sparkfunX/Qwiic_Spectral_Sensor-AS726x/Hardware/AS726xBasicShroud.stl

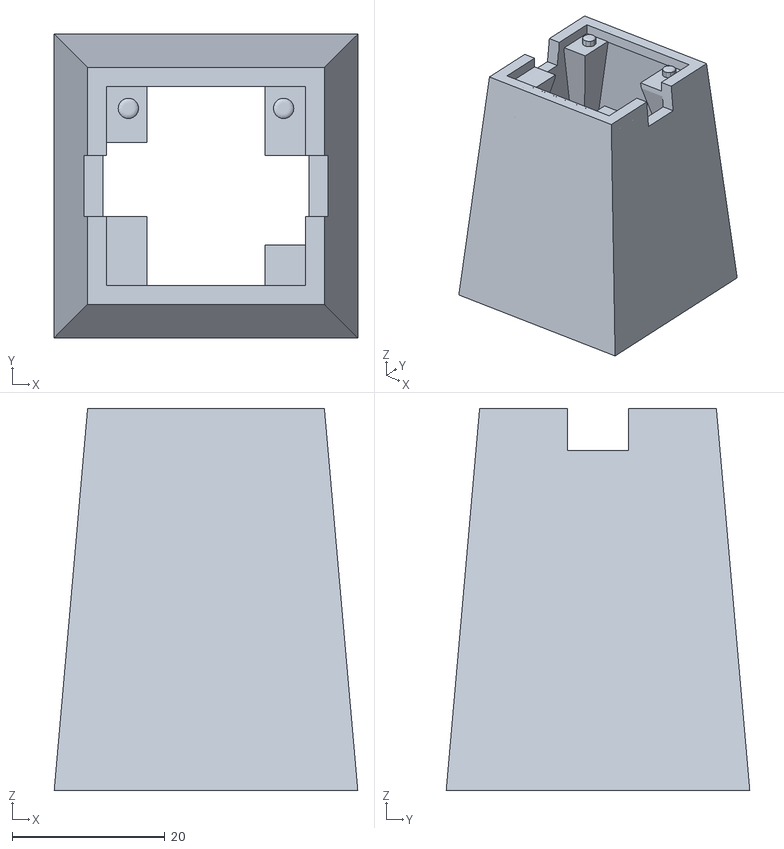
[picture p1: CAD file, 2017-04-14]
Hardware/AS726xBasicShroud.stl
39.7 x 39.7 x 50.0
