sparkfunX/Qwiic_Spectral_Sensor-AS726x/Hardware/Qwiic_Spectral_Sensor-AS726x.pdf

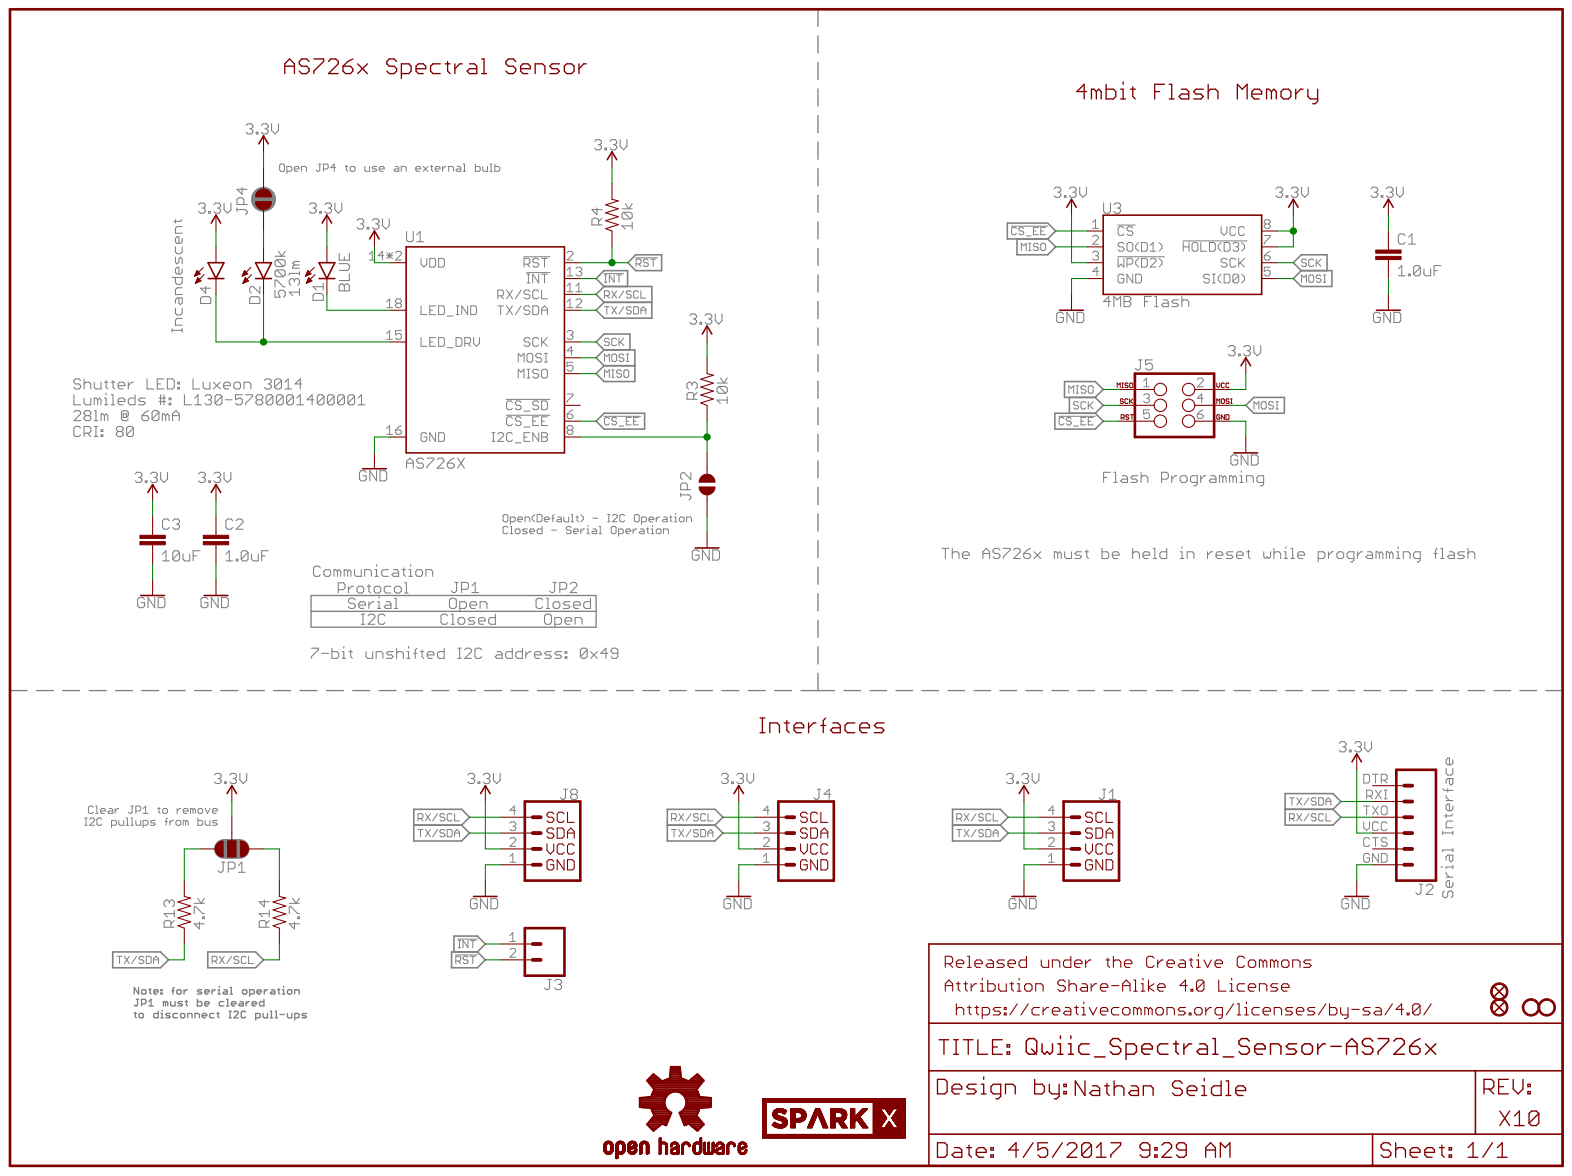
[picture p2: page 1]
