sparkfunX/Qwiic_Spectral_Sensor-AS726x/Hardware/Qwiic_Spectral_Sensor-AS726x.brd

## EAGLE design Hardware/Qwiic_Spectral_Sensor-AS726x.brd (2017-03-31)

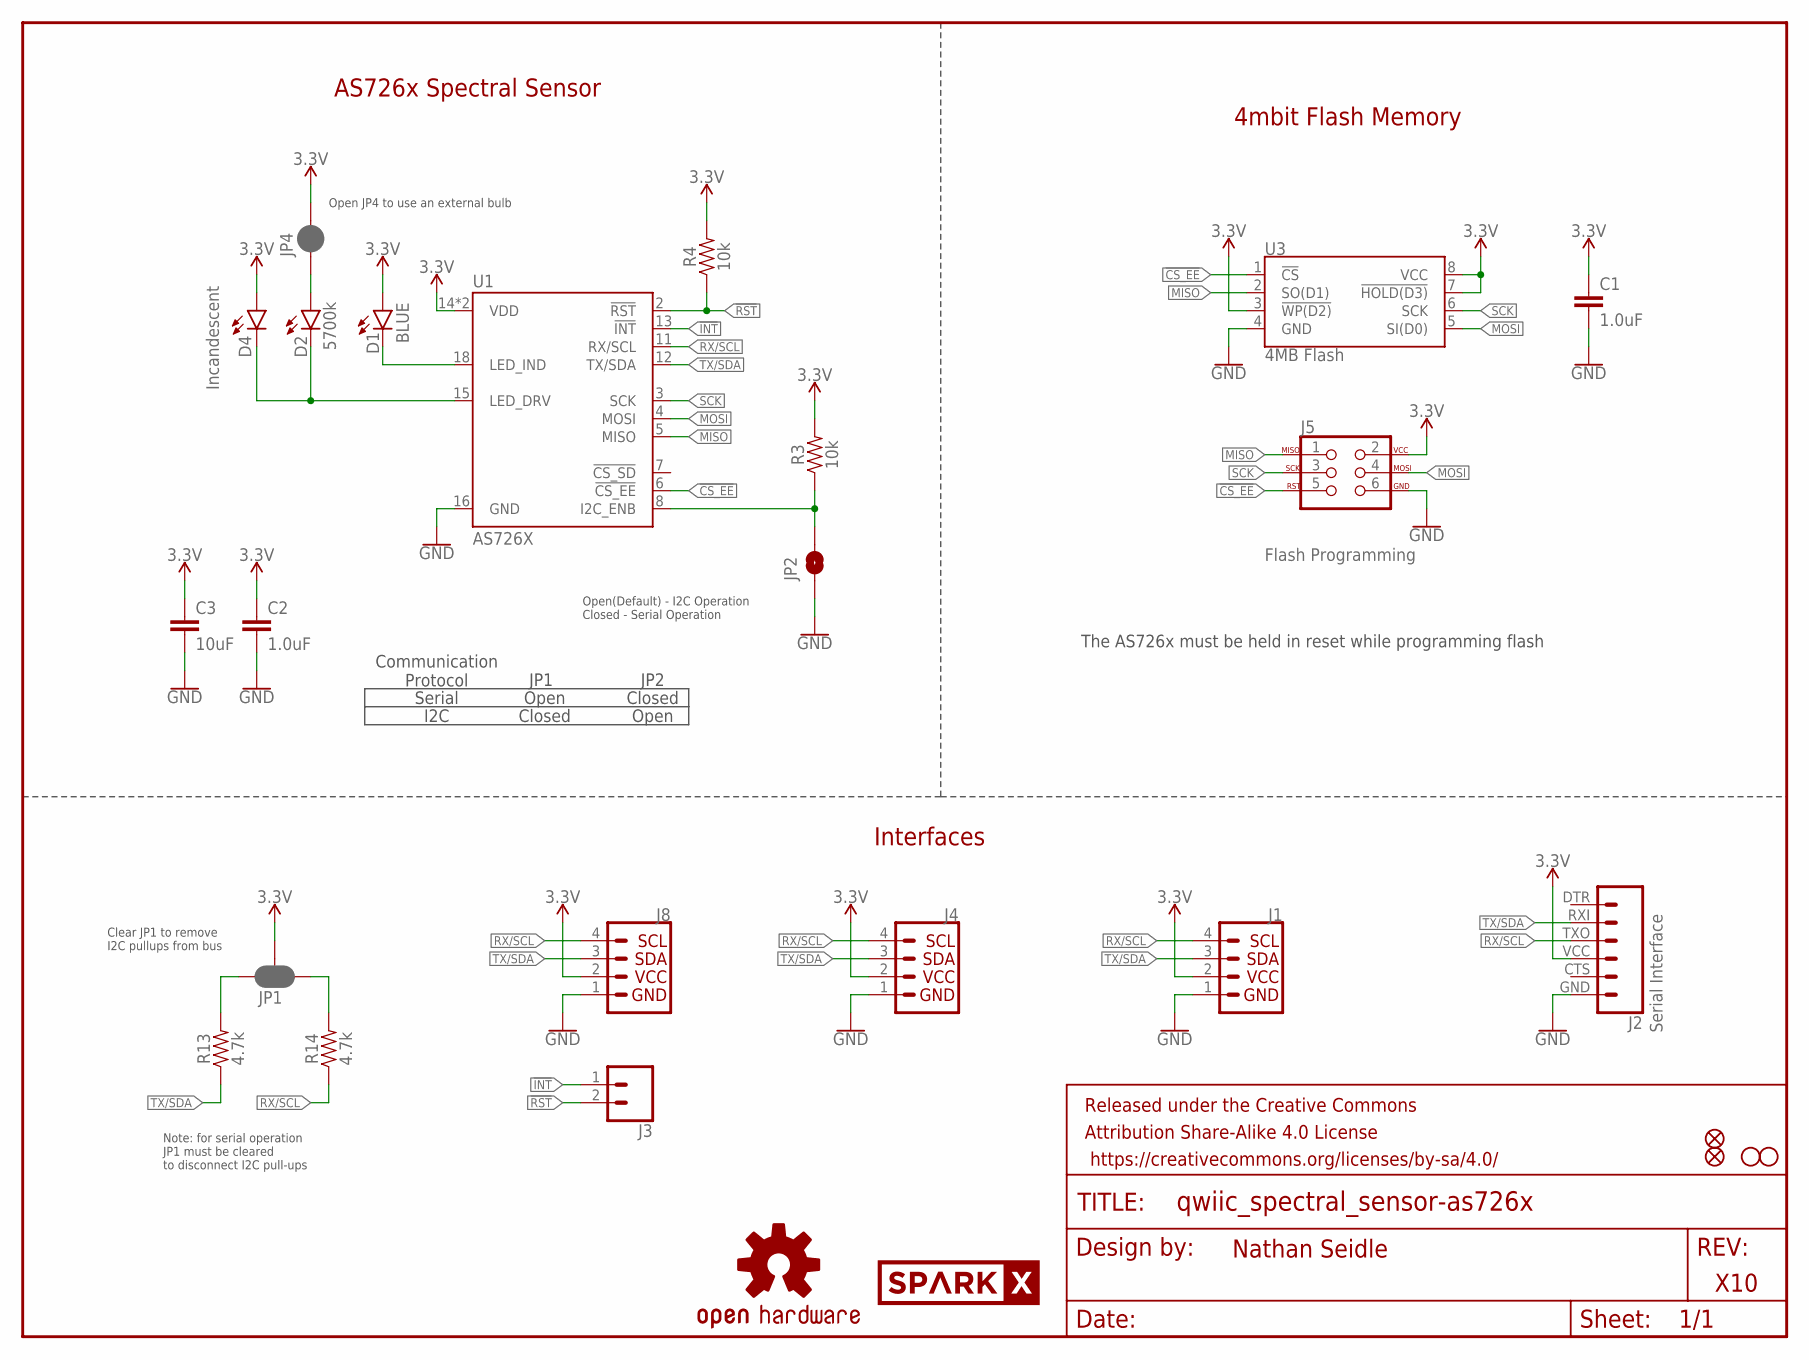
[picture p3: schematic Qwiic_Spectral_Sensor-AS726x.sch]

Parts:
C1, C2: 1.0uF; 0603
C3: 10uF; 0603
D1: BLUE; LED-0603
D2: 5700k; SUPER_BRIGHT_SMD_LED_1206
D4: Incandescent; LED_5MM_NOSILK
FD1, FD2: FIDUCIAL1X2; FIDUCIAL-1X2
FRAME1: FRAME-LETTER; CREATIVE_COMMONS
H2, H4: STAND-OFF
J1, J4: I2C_STANDARDJS-1MM; 1X04_1MM_RA
J2: Serial Interface; FTDI_BASIC
J3: CONN_021X02_NO_SILK; 1X02_NO_SILK
J5: Flash Programming; 2X3_TEST_POINTS
J8: I2C_STANDARD_NO_SILK; 1X04_NO_SILK
JP1: JUMPER-SMT_3_2-NC_PASTE_SILK; SMT-JUMPER_3_2-NC_PASTE_SILK
JP2: JUMPER-SMT_2_NO_SILK; SMT-JUMPER_2_NO_SILK
JP4: JUMPER-SMT_2_NC_PASTE_NO-SILK; SMT-JUMPER_2_NC_PASTE_NO-SILK
LOGO4: OSHW-LOGOS; OSHW-LOGO-S
R3, R4: 10k; 0603
R13, R14: 4.7k; 0603
U1: AS726X; LGA20
U3: 4MB Flash; SO08
U$1: SPARKX-LOGO3; SPARKX-SMALL

Connections:
3.3V: C1.1, C2.1, C3.1, D1.A, D4.A, J1.2 (VCC), J2.VCC (4), J4.2 (VCC), J5.2, J8.2, JP1.2, JP4.2, R3.2, R4.2, U1.14 (VDD), U1.17 (VDD), U3.3 (!WP(D2)), U3.7 (!HOLD(D3)), U3.8 (VCC)
!CS_EE: J5.5, U1.6 (!CS_EE), U3.1 (!CS)
!INT: J3.1, U1.13 (!INT)
!RST: J3.2, R4.1, U1.2 (!RST)
GND: C1.2, C2.2, C3.2, J1.1 (GND), J2.GND (6), J4.1 (GND), J5.6, J8.1, JP2.1, U1.16 (GND), U3.4 (GND)
LED_DRV: D2.C, D4.K (C), U1.15 (LED_DRV)
MISO: J5.1, U1.5 (MISO), U3.2 (SO(D1))
MOSI: J5.4, U1.4 (MOSI), U3.5 (SI(D0))
unnamed: JP2.2, R3.1, U1.8 (I2C_ENB)
unnamed: D1.C, U1.18 (LED_IND)
unnamed: JP1.3, R13.2
unnamed: JP1.1, R14.2
unnamed: D2.A, JP4.1
RX/SCL: J1.4 (SCL), J2.TXO (3), J4.4 (SCL), J8.4, R14.1, U1.11 (RX/SCL)
SCK: J5.3, U1.3 (SCK), U3.6 (SCK)
TX/SDA: J1.3 (SDA), J2.RXI (2), J4.3 (SDA), J8.3, R13.1, U1.12 (TX/SDA)

Notes on the sheet:
AS726x Spectral Sensor
Open(Default) - I2C Operation Closed - Serial Operation
Clear JP1 to remove I2C pullups from bus
X10
Nathan Seidle
4mbit Flash Memory
Interfaces
Note: for serial operation JP1 must be cleared to disconnect I2C pull-ups
The AS726x must be held in reset while programming flash
Open JP4 to use an external bulb
Serial
JP1
JP2
Open
Closed
Communication Protocol
I2C

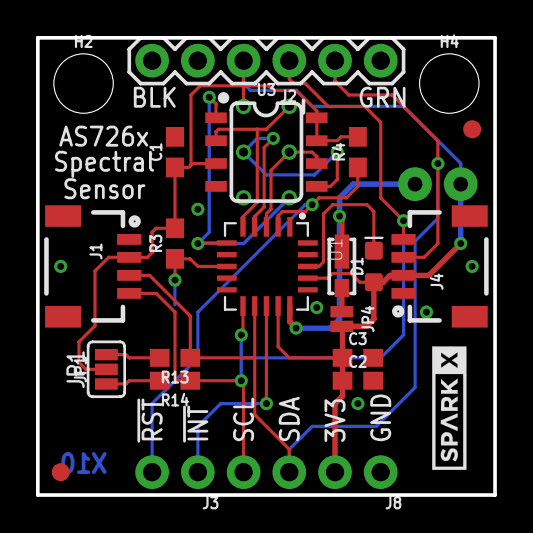
[picture p4: board Qwiic_Spectral_Sensor-AS726x.brd from above]

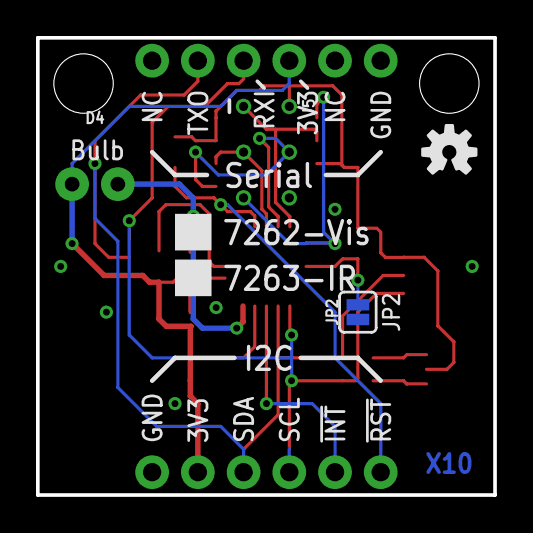
[picture p5: board Qwiic_Spectral_Sensor-AS726x.brd from below]

Board: 2 copper layers, 25.4 x 25.4 mm, 28 parts (4 on the bottom side), 16 nets.
