sparkfunX/Qwiic_Spectral_Sensor-AS726x/(commit log)

2017-03-03 Initial layout
    [AS726x_Breakout.brd, AS726x_Breakout.sch, Millable_AS726x_Breakout.brd, Millable_AS726x_Breakout.sch]
2017-03-15 Adding firmware, panel, and small fix to dimension on main layout.
    [AS726x Spectral Sensor Panel.GBL, AS726x Spectral Sensor Panel.GBO, AS726x Spectral Sensor Panel.GBS, AS726x Spectral Sensor Panel.GKO, AS726x Spectral Sensor Panel.GTL, AS726x Spectral Sensor Panel.GTO, AS726x Spectral Sensor Panel.GTP, AS726x Spectral Sensor Panel.GTS]
2017-03-31 Examples are fully functional
    [AS726x Spectral Sensor Panel-NoGaps.GBL, AS726x Spectral Sensor Panel-NoGaps.GBO, AS726x Spectral Sensor Panel-NoGaps.GBS, AS726x Spectral Sensor Panel-NoGaps.GKO, AS726x Spectral Sensor Panel-NoGaps.GTL, AS726x Spectral Sensor Panel-NoGaps.GTO, AS726x Spectral Sensor Panel-NoGaps.GTP, AS726x Spectral Sensor Panel-NoGaps.GTS]
2017-03-31 Cleaning up file structure. Removing old files.
    [AS726x Spectral Sensor Panel-NoGaps.GBL, AS726x Spectral Sensor Panel-NoGaps.GBO, AS726x Spectral Sensor Panel-NoGaps.GBS, AS726x Spectral Sensor Panel-NoGaps.GKO, AS726x Spectral Sensor Panel-NoGaps.GTL, AS726x Spectral Sensor Panel-NoGaps.GTO, AS726x Spectral Sensor Panel-NoGaps.GTP, AS726x Spectral Sensor Panel-NoGaps.GTS]
2017-04-05 Adding AS7263 firmware. Adding I2C address to schematic. Adding LED datasheet.
    [Qwiic_Spectral_Sensor-AS726x.sch]
2017-04-14 Add files via upload
    Added 3D shroud file (.stl)
    [AS726xBasicShroud.stl]
